Sujan133/6S-Sensorless_BLDC_ESC/Schematic/SCH_Schematic1_1_2026-07-18.pdf

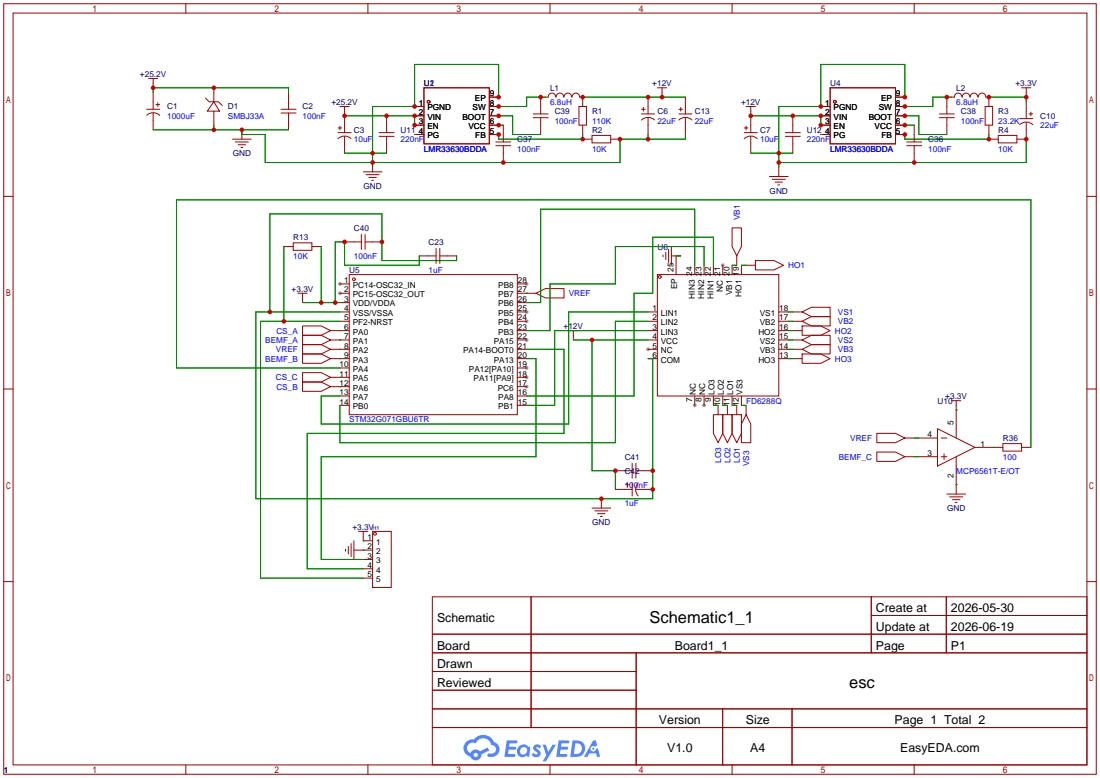
[picture p10: page 1]

Schematic | Schematic1_1 | Create at | 2026-05-30

Update at | 2026-06-19

Board | Board1_1 | Page | P1
Drawn | | esc
Reviewed

Version | Size | Page 1 Total 2
V1.0 | A4 | EasyEDA.com

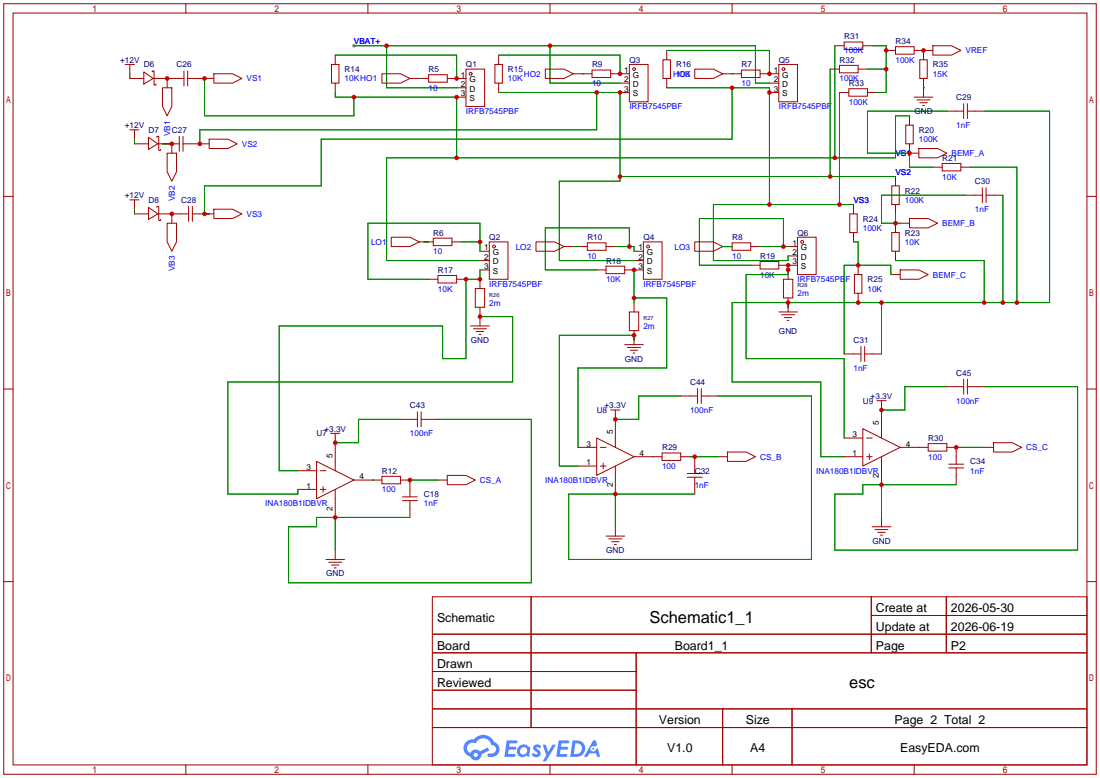
[picture p11: page 2]

Schematic | Schematic1_1 | Create at | 2026-05-30

Update at | 2026-06-19

Board | Board1_1 | Page | P2
Drawn | | esc
Reviewed

Version | Size | Page 2 Total 2
V1.0 | A4 | EasyEDA.com
