Sujan133/6S-Sensorless_BLDC_ESC/(list of files, drawings)

Other design files:
esc.eprj
