Sujan133/6S-Sensorless_BLDC_ESC/Filmware/ESC.ioc

Mcu.UserName=STM32G071GBUx
PA0.Signal=ADC1_IN0
PA1.Signal=COMP1_INP
PA13.Signal=SYS_SWDIO
PA14-BOOT0.Signal=SYS_SWCLK
PA3.Signal=COMP2_INP
PA4.Signal=ADC1_IN4
PA5.Signal=ADC1_IN5
PA6.Signal=ADC1_IN6
PA7.Signal=TIM1_CH1N
PA8.Signal=S_TIM1_CH1
PB0.Signal=TIM1_CH2N
PB1.Signal=TIM1_CH3N
PB3.Signal=S_TIM1_CH2
PB6.Signal=S_TIM1_CH3
PB7.Signal=COMP2_INM
